RoboticsBrno/RB3203-BlackBox/touchboard/TouchBoard.jpg

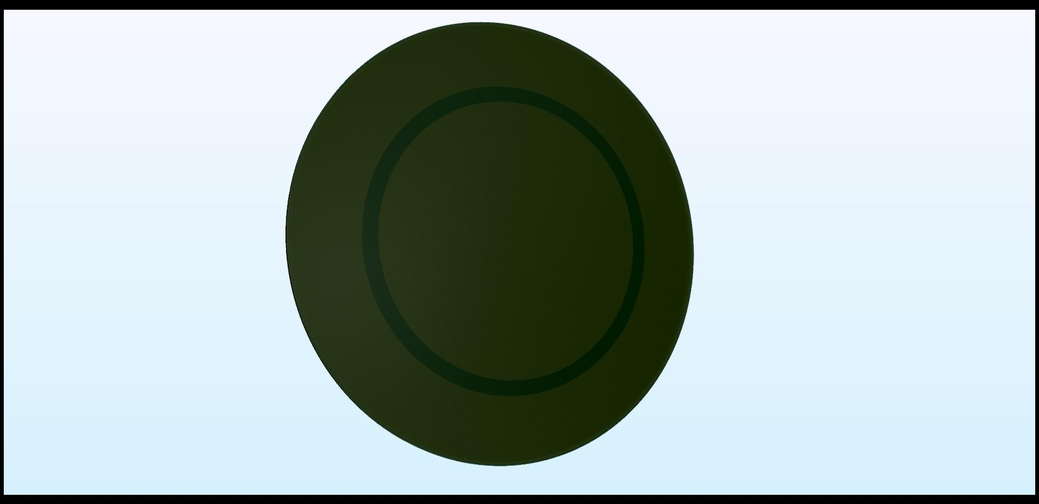
touchboard/TouchBoard.jpg
