RoboticsBrno/RB3203-BlackBox/hw/old/main_board/B.B-V1.0/birokracie/9627741863_awb51.pdf

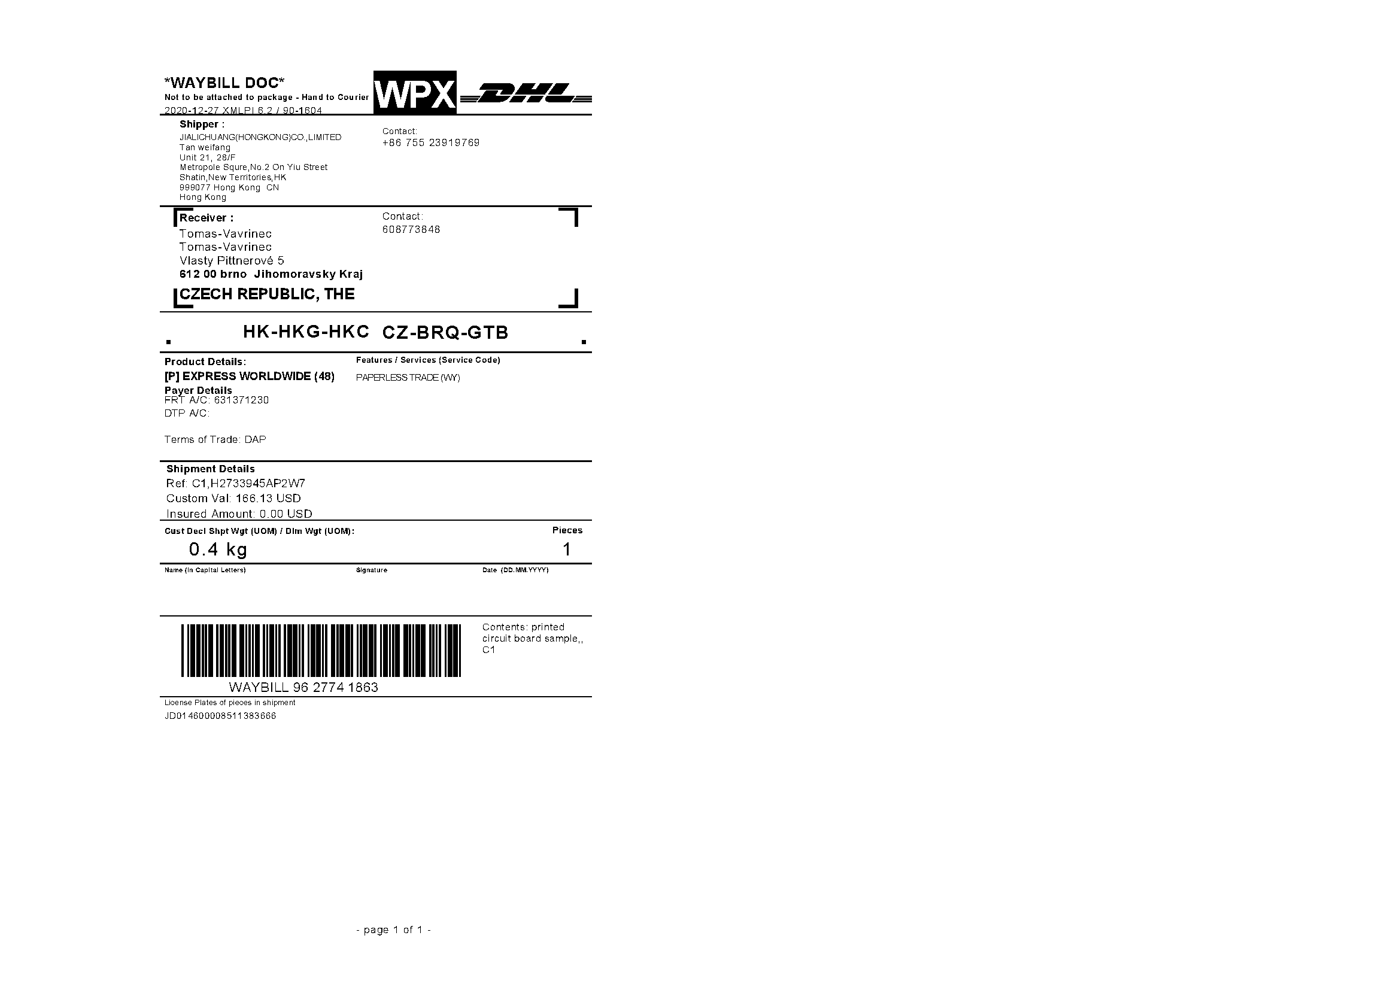
[picture p2: page 1]
