RoboticsBrno/RB3203-BlackBox/hw/old/main_board/B.B-V1.0/birokracie/9627741863_inv50 (1).pdf

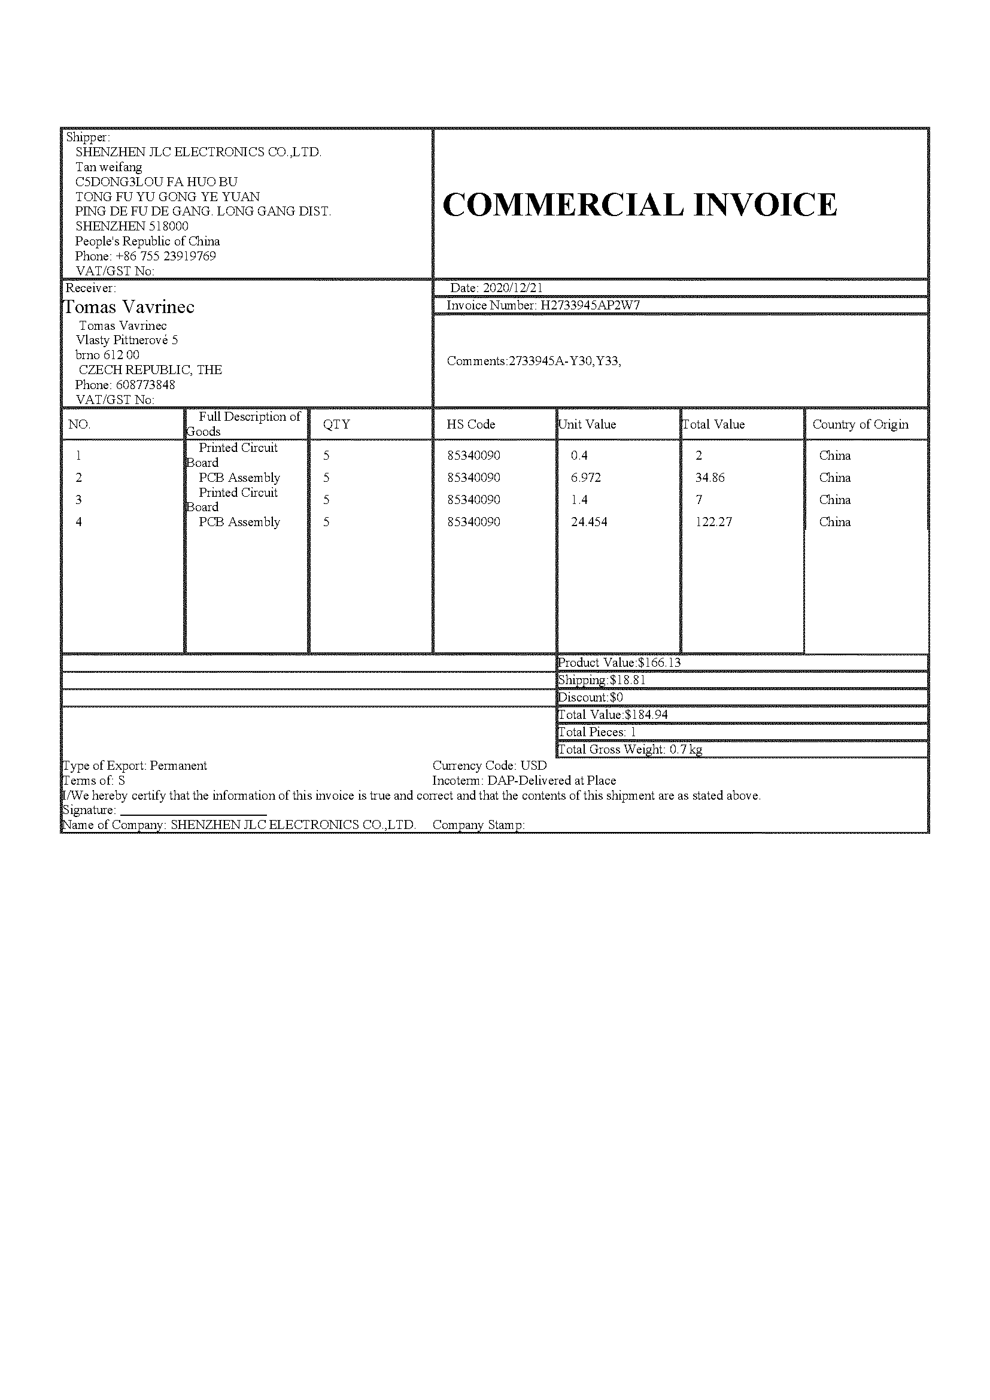
[picture p3: page 1]
