RoboticsBrno/RB3203-BlackBox/touchboard/tmave.png

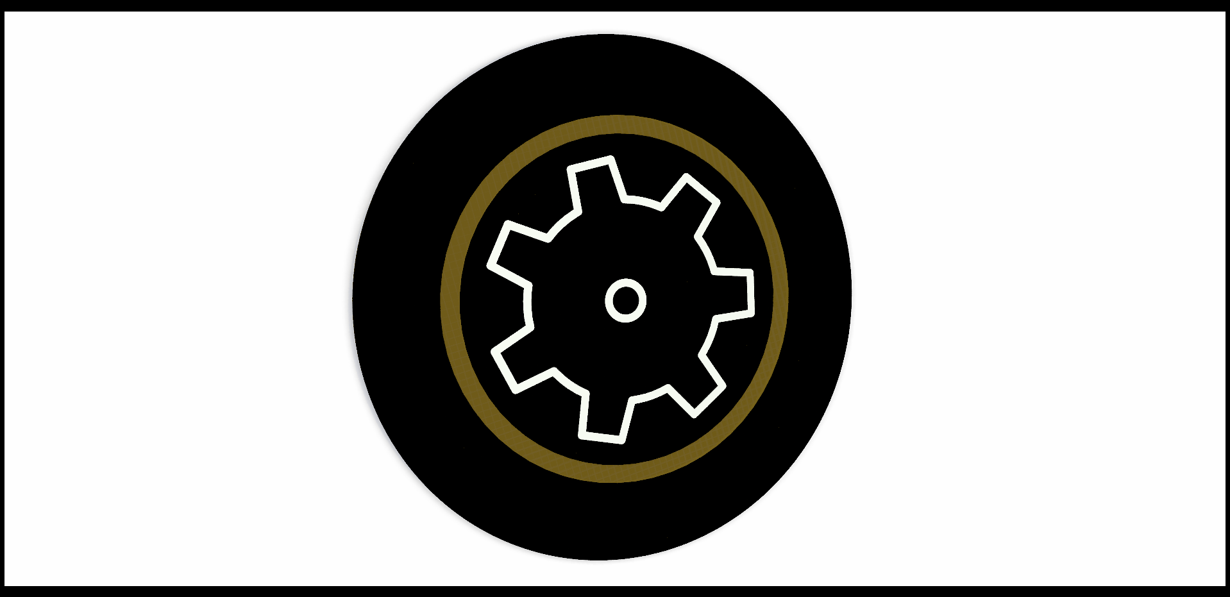
touchboard/tmave.png
