RoboticsBrno/RB3203-BlackBox/touchboard/TouchBoard.png

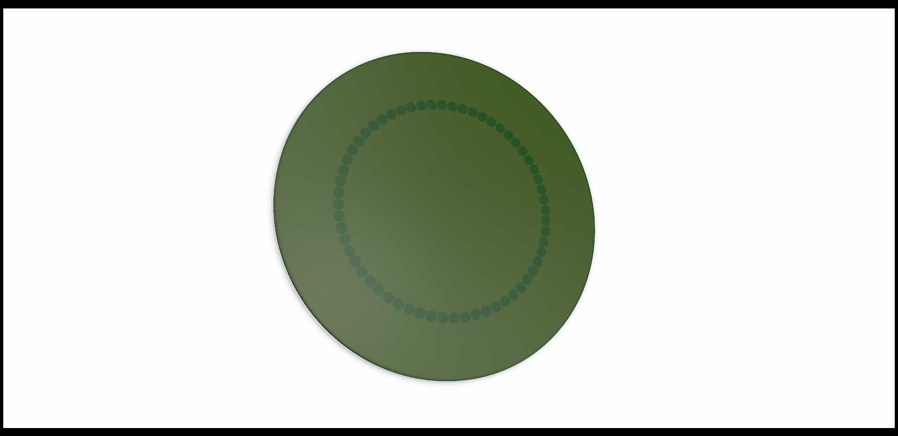
touchboard/TouchBoard.png
