RoboticsBrno/RB3203-BlackBox/main_board/main_board 1.0.0/BOM.xlsx

Comment | Designator | Footprint | LCSC Part #（optional）
2.2nF | C1,C2 | 0402_C | C1531
100nF | C3, C4, C8 | 0402_C | C307331
10uF | C5,C69,C70,C72,C73,C74 | 0402_C | C15195
220nF | C6 | 0402_C | C21120
4.7uF | C7,C71 | 0402_C | C1779
18pF | C9-68 | 0402_C | C1647
 | D1-2 | SMC,DO-214AB | C284071
 | IC1 | SOIC-16_7.5x10.3x1.27P | C9866
 | IC2 | LGA-16_3x3x0.5P | C192585
 | LED4 | LED_0603 | C72041
 | MAX1 | SOIC-8_3.9x4.9x1.27P | C19738
 | Q1,Q4,Q5,Q6,Q10 | SOT-23-3 | C232275
 | Q2,Q3,Q8,Q9 | SOP-8_EP_5.0x5.0x1.27P | C180399
12KΩ | R2-5,R8-9,R16,R20,R24 | 0402_R | C25752
300KΩ | R6 | 0402_R | C25102
220Ω | R7,R10,R21,R23,R25,R26,R47 | 0402_R | C25092
100KΩ | R11,R17,R19,R22 | 0402_R | C25741
120Ω | R12 | 0402_R | C25750
20KΩ | R13-14 | 0402_R | C25765
330KΩ | R15 | 0603_R | C23137
1MΩ | R18 | 0603_R | C22935
 | U1 | QFN-24_EP_4.0x4.0x0.5P | C24112
 | U$2-61 | LED-4_3535 | C114583
