RoboticsBrno/RB3203-BlackBox/(list of files, cad)

Other CAD files:
main_board/B.B-V1.2-Lucerna/3D_vystup/QFN-24-1EP_4x4mm_P0.5mm_EP2.6x2.6mm.step.SLDASM
main_board/B.B-V1.2-Lucerna/3D_vystup/PinHeader_1x04_P2.54mm_Vertical.step.SLDASM
main_board/B.B-V1.2-Lucerna/3D_vystup/LGA-16_3x3mm_P0.5mm.step.SLDASM
main_board/B.B-V1.2-Lucerna/3D_vystup/DFN-6-1EP_3x3mm_P1mm_EP1.5x2.4mm.step.SLDASM
main_board/B.B-V1.2-Lucerna/3D_vystup/JST_EH_B2B-EH-A_1x02_P2.50mm_Vertical.step.SLDASM
main_board/B.B-V1.2-Lucerna/3D_vystup/COMPOUND-22.step.SLDPRT
hw/old/main_board/B.B-V1.2-Lucerna/3D_vystup/PinHeader_1x04_P2.54mm_Vertical.step.SLDASM
hw/old/main_board/B.B/3D_vystup/LGA-16_3x3mm_P0.5mm.step.SLDASM
hw/old/main_board/B.B-V1.1/3D_vystup/PinHeader_1x04_P2.54mm_Vertical.step.SLDASM
hw/old/main_board/B.B/3D_vystup/QFN-24-1EP_4x4mm_P0.5mm_EP2.6x2.6mm.step.SLDASM
hw/old/main_board/B.B-V1.2-Lucerna/3D_vystup/LGA-16_3x3mm_P0.5mm.step.SLDASM
hw/old/main_board/B.B/3D_vystup/DFN-6-1EP_3x3mm_P1mm_EP1.5x2.4mm.step.SLDASM
hw/old/main_board/B.B-V1.2-Lucerna/3D_vystup/QFN-24-1EP_4x4mm_P0.5mm_EP2.6x2.6mm.step.SLDASM
hw/old/main_board/B.B/3D_vystup/PinHeader_1x04_P2.54mm_Vertical.step.SLDASM
hw/old/main_board/B.B-V1.2-Lucerna/3D_vystup/JST_EH_B2B-EH-A_1x02_P2.50mm_Vertical.step.SLDASM
hw/old/main_board/B.B/3D_vystup/JST_EH_B2B-EH-A_1x02_P2.50mm_Vertical.step.SLDASM
hw/old/main_board/B.B-V1.2-Lucerna/3D_vystup/DFN-6-1EP_3x3mm_P1mm_EP1.5x2.4mm.step.SLDASM
hw/old/main_board/B.B-V1.1/3D_vystup/DFN-6-1EP_3x3mm_P1mm_EP1.5x2.4mm.step.SLDASM
hw/old/main_board/B.B-V1.1/3D_vystup/COMPOUND-22.step.SLDPRT
hw/old/main_board/B.B-V1.1/3D_vystup/JST_EH_B2B-EH-A_1x02_P2.50mm_Vertical.step.SLDASM
hw/old/main_board/B.B-V1.1/3D_vystup/LGA-16_3x3mm_P0.5mm.step.SLDASM
hw/old/main_board/B.B-V1.1/3D_vystup/QFN-24-1EP_4x4mm_P0.5mm_EP2.6x2.6mm.step.SLDASM
hw/old/main_board/B.B-V1.1/3D_vystup/SOLID-10.step.SLDPRT
hw/old/main_board/B.B-V1.1/3D_vystup/SOLID-12.step.SLDPRT
hw/old/main_board/B.B-V1.1/3D_vystup/SOLID-13.step.SLDPRT
hw/old/main_board/B.B-V1.1/3D_vystup/SOLID-15.step.SLDPRT
hw/old/main_board/B.B-V1.1/3D_vystup/SOLID-16.step.SLDPRT
hw/old/main_board/B.B-V1.1/3D_vystup/SOLID-17.step.SLDPRT
hw/old/main_board/B.B-V1.1/3D_vystup/SOLID-18.step.SLDPRT
hw/old/main_board/B.B-V1.1/3D_vystup/SOLID-2.step.SLDPRT
hw/old/main_board/B.B-V1.1/3D_vystup/SOLID-5.step.SLDPRT
hw/old/main_board/B.B-V1.1/3D_vystup/SOLID-8.step.SLDPRT
hw/old/main_board/B.B-V1.1/3D_vystup/SOLID-9.step.SLDPRT
hw/old/main_board/B.B-V1.2-Lucerna/3D_vystup/COMPOUND-22.step.SLDPRT
hw/old/main_board/B.B/3D_vystup/COMPOUND-22.step.SLDPRT
