RoboticsBrno/RB3203-BlackBox/main_board/B.B-V1.2-Lucerna/B.B.kicad_pcb

## KiCad design main_board/B.B-V1.2-Lucerna/B.B.kicad_pcb (2021-05-26)

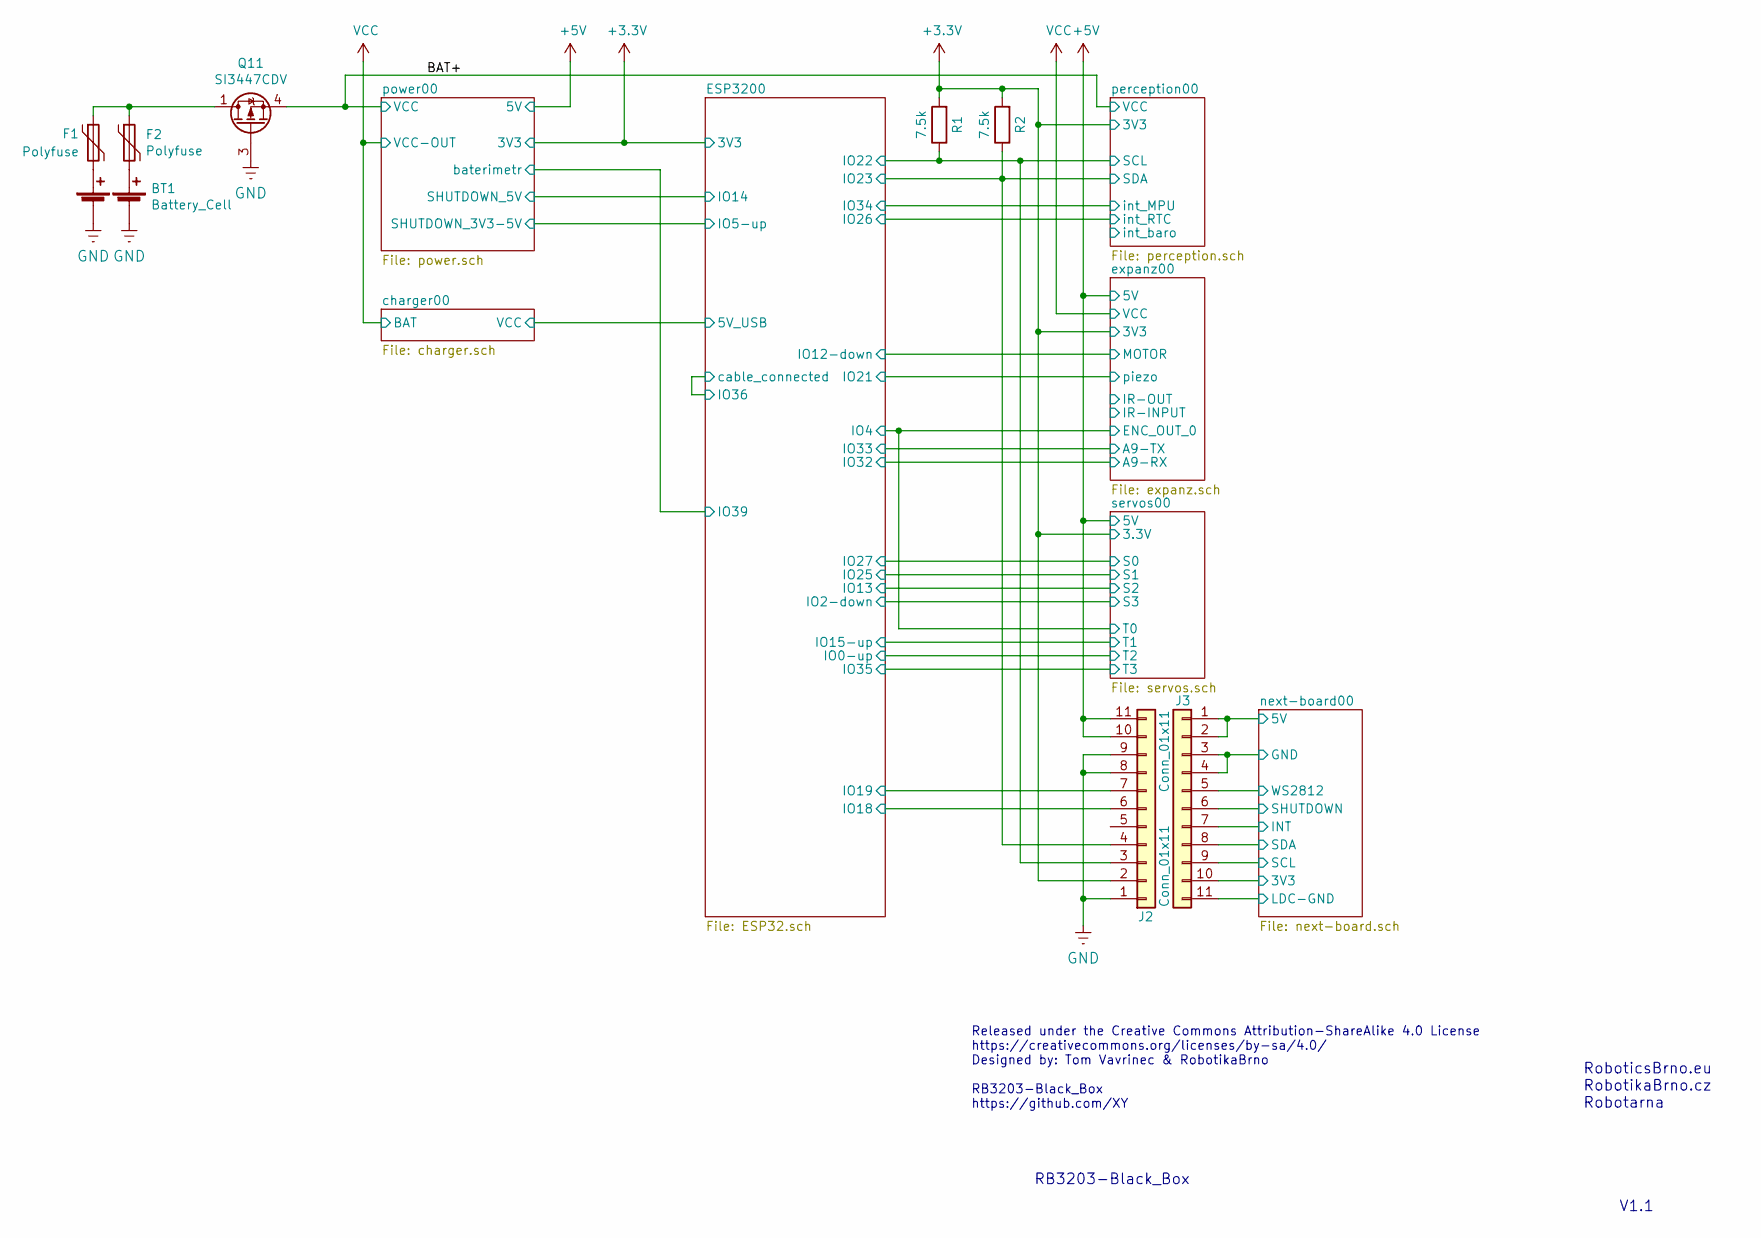
[picture p6: schematic B.B.sch]

Parts:
BT1: Battery_Cell; 18650-holder
F1, F2: Polyfuse; L_1206_3216Metric; LCSC C20988
J2, J3: Conn_01x11; PinHeader_1x11_P2.54mm_Vertical
Q11: SI3447CDV; TSOP-6_1.5x3.0x0.95P; LCSC C144884
R1, R2: 7.5k; R_0402_1005Metric; LCSC C25918

Connections:
+3V3: J2.2, R1.2, R2.2; also elsewhere on the board
+5V: J2.10, J2.11; also elsewhere on the board
/BAT+: Q11.4 (S); also elsewhere on the board
/ESP3200/IO18: J2.6; also elsewhere on the board
/ESP3200/IO19: J2.7; also elsewhere on the board
/ESP3200/IO22: J2.3, R1.1; also elsewhere on the board
/ESP3200/IO23: J2.4, R2.1; also elsewhere on the board
/next-board00/3V3: J3.10; also elsewhere on the board
/next-board00/5V: J3.1, J3.2; also elsewhere on the board
/next-board00/GND: J3.3, J3.4; also elsewhere on the board
/next-board00/INT: J3.7; also elsewhere on the board
/next-board00/LDC-GND: J3.11; also elsewhere on the board
/next-board00/SCL: J3.9; also elsewhere on the board
/next-board00/SDA: J3.8; also elsewhere on the board
/next-board00/SHUTDOWN: J3.6; also elsewhere on the board
/next-board00/WS2812: J3.5; also elsewhere on the board
unnamed: BT1.1 (+), F2.2
unnamed: BT1.3 (+), F1.2
unnamed: F1.1, F2.1, Q11.1 (D), Q11.2, Q11.5, Q11.6

Notes on the sheet:
Released under the Creative Commons Attribution-ShareAlike 4.0 License https://creativecommons.org/licenses/by-sa/4.0/ Designed by: Tom Vavrinec & RobotikaBrno RB3203-Black_Box https://github.com/XY
RoboticsBrno.eu RobotikaBrno.cz Robotarna
V1.1
RB3203-Black_Box

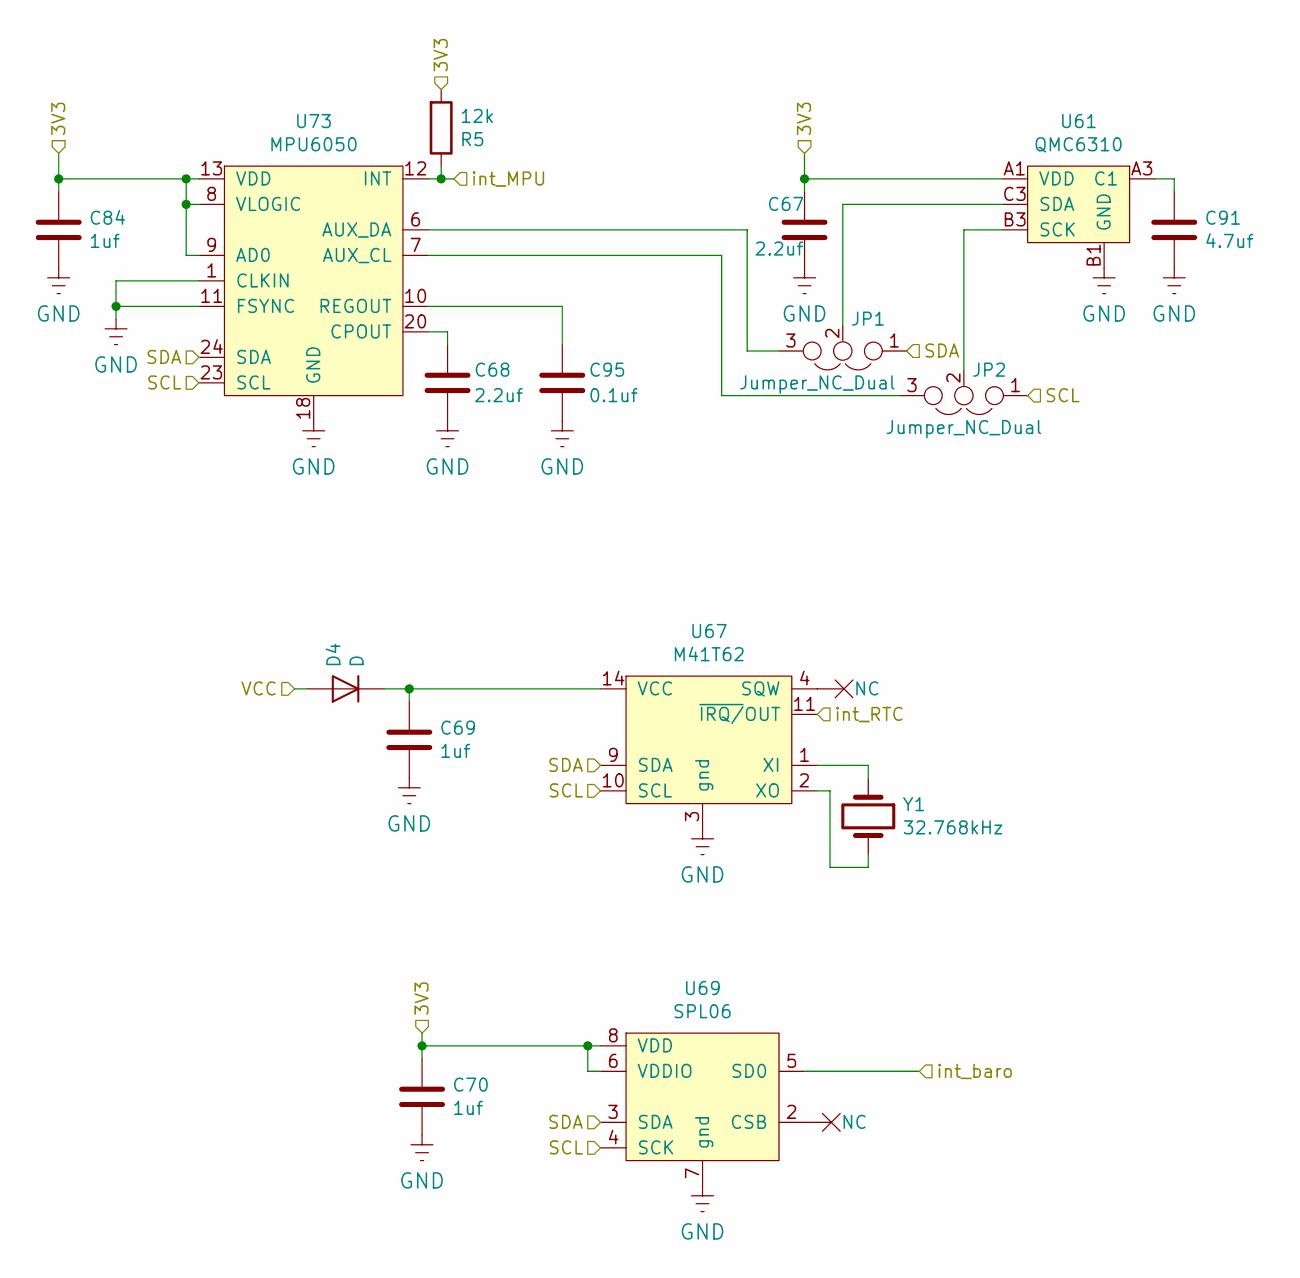
[picture p7: schematic perception.sch]

Parts:
C67, C68: 2.2uf; C_0402_1005Metric; LCSC C12530
C84, C117, C118: 1uf; R_0402_1005Metric; LCSC C52923
C91: 4.7uf; C_0402_1005Metric; LCSC C23733
C95: 0.1uf; R_0402_1005Metric; LCSC C1525
D4: D; SOD-323; LCSC C109204
JP1, JP2: Jumper_NC_Dual; SolderJumper-3_P1.3mm_Bridged12_RoundedPad1.0x1.5mm_NumberL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
R5: 12k; R_0402_1005Metric; LCSC C25752
U61: QMC6310; LCSC C669299
U70: M41T62; QFN-16-1EP_3x3mm_P0.5mm_EP1.7x1.7mm; LCSC C113207
U71: SPL06; SMD-8_2x2.5x0.65P; LCSC C2684428
U73: MPU6050; QFN-24-1EP_4x4mm_P0.5mm_EP2.6x2.6mm; LCSC C24112
Y1: 32.768kHz; SMD-3215_2P; LCSC C156244

Connections:
+3V3: C67.1, C84.1, R5.2, U61.A1 (VDD), U71.6 (VDDIO), U71.8 (VDD), U73.8 (VLOGIC), U73.9 (AD0), U73.13 (VDD); also elsewhere on the board
/BAT+: D4.2 (A); also elsewhere on the board
/ESP3200/IO22: JP2.1, U71.4 (SCK), U73.23 (SCL); also elsewhere on the board
/ESP3200/IO23: JP1.1, U71.3 (SDA), U73.24 (SDA); also elsewhere on the board
/ESP3200/IO34: R5.1, U73.12 (INT); also elsewhere on the board
unnamed: C68.1, U73.20 (CPOUT)
unnamed 57: D4.1 (K); also elsewhere on the board
unnamed: C91.1, U61.A3 (C1)
unnamed: C95.1, U73.10 (REGOUT)
unnamed: JP1.2, U61.C3 (SDA)
unnamed: JP1.3, U73.6 (AUX_DA)
unnamed: JP2.2, U61.B3 (SCK)
unnamed: JP2.3, U73.7 (AUX_CL)
unnamed 150: Y1.1; also elsewhere on the board
unnamed 151: Y1.2; also elsewhere on the board

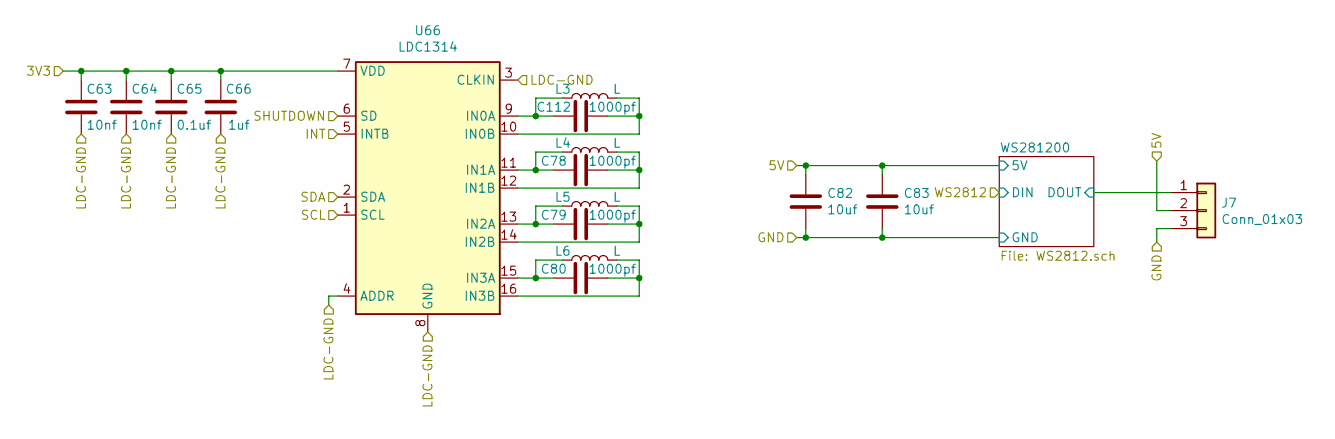
[picture p8: schematic next-board.sch]

Parts:
C63, C64: 10nf; C_0402_1005Metric; LCSC C15195
C65: 0.1uf; R_0402_1005Metric; LCSC C1525
C66: 1uf; C_0402_1005Metric; LCSC C52923
C78, C79, C80, C112: 1000pf; C_0402_1005Metric; LCSC C1523
C82, C83: 10uf; C_0805_2012Metric; LCSC C15850
J7: Conn_01x03; PinHeader_1x03_P2.54mm_Vertical
L3, L4, L5, L6: L; coil
U66: LDC1314; WQFN-16-1EP_4x4mm_P0.5mm_EP2.6x2.6mm_ThermalVias; LCSC C80399

Connections:
/next-board00/3V3: C63.1, C64.1, C65.1, C66.2, U66.7 (VDD); also elsewhere on the board
/next-board00/5V: C82.1, C83.1, J7.2; also elsewhere on the board
/next-board00/GND: C82.2, C83.2, J7.3; also elsewhere on the board
/next-board00/INT: U66.5 (INTB); also elsewhere on the board
/next-board00/LDC-GND: C63.2, C64.2, C65.2, C66.1, U66.3 (CLKIN), U66.4 (ADDR), U66.8 (GND), U66.17 (GND); also elsewhere on the board
/next-board00/SCL: U66.1 (SCL); also elsewhere on the board
/next-board00/SDA: U66.2 (SDA); also elsewhere on the board
/next-board00/SHUTDOWN: U66.6 (SD); also elsewhere on the board
/next-board00/WS281200/DOUT: J7.1; also elsewhere on the board
unnamed: C78.1, L4.1, U66.12 (IN1B)
unnamed: C78.2, L4.2, U66.11 (IN1A)
unnamed: C79.1, L5.1, U66.14 (IN2B)
unnamed: C79.2, L5.2, U66.13 (IN2A)
unnamed: C80.1, L6.1, U66.16 (IN3B)
unnamed: C80.2, L6.2, U66.15 (IN3A)
unnamed: C112.1, L3.1, U66.10 (IN0B)
unnamed: C112.2, L3.2, U66.9 (IN0A)

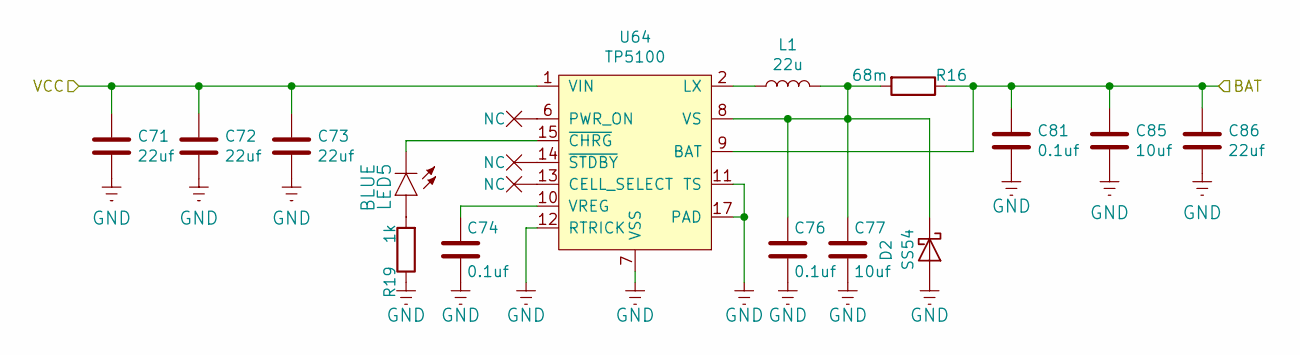
[picture p9: schematic charger.sch]

Parts:
C71, C72, C73, C86: 22uf; C_0805_2012Metric; LCSC C45783
C74, C76, C81: 0.1uf; C_0805_2012Metric; LCSC C49678
C77, C85: 10uf; C_0805_2012Metric; LCSC C15850
D2: SS54; DO-214AC; LCSC C22452
L1: 22u; MCF-1040; LCSC C169268
LED5: BLUE; LED_0603_1608Metric; LCSC C72041
R16: 68m; R_1210_3225Metric; LCSC C422195
R19: 1k; R_0402_1005Metric; LCSC C11702
U64: TP5100; QFN-16-1EP_4x4mm_P0.65mm_EP2.5x2.5mm_ThermalVias; LCSC C379389

Connections:
unnamed: C74.1, U64.10 (VREG)
unnamed: C76.1, C77.1, D2.1 (K), L1.2, R16.2, U64.8 (VS)
unnamed: L1.1, U64.2 (LX), U64.3 (LX)
unnamed: LED5.1 (C), U64.15 (~CHRG)
unnamed: LED5.2 (A), R19.2
VIN: C71.1, C72.1, C73.1, U64.1 (VIN), U64.4 (VIN), U64.5 (VIN), U64.16 (VIN); also elsewhere on the board

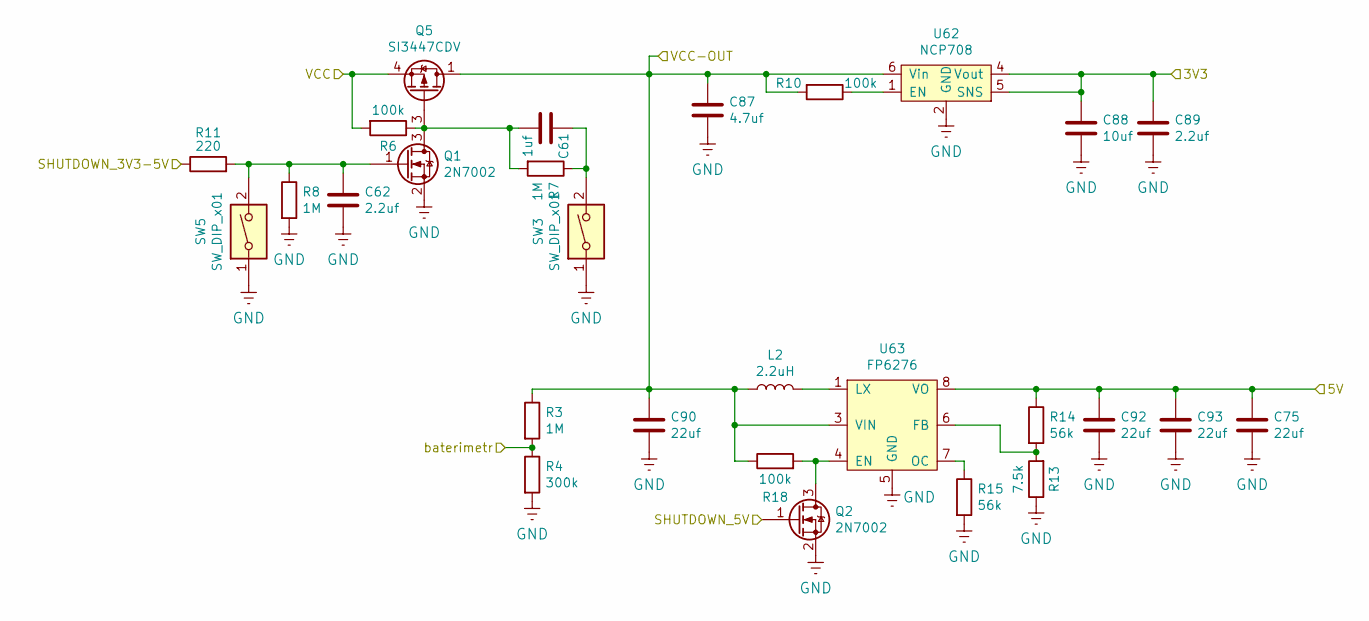
[picture p10: schematic power.sch]

Parts:
C61: 1uf; C_0402_1005Metric; LCSC C52923
C62, C89: 2.2uf; C_0805_2012Metric; LCSC C49217
C75, C90, C92, C93: 22uf; C_0805_2012Metric; LCSC C45783
C87: 4.7uf; C_0805_2012Metric; LCSC C1779
C88: 10uf; C_0805_2012Metric; LCSC C15850
L2: 2.2uH; MWSA0603_6.6x7.1x3.0; LCSC C351096
Q1, Q2: 2N7002; SOT-23; LCSC C8545
Q5: SI3447CDV; TSOP-6_1.5x3.0x0.95P; LCSC C144884
R3, R7, R8: 1M; R_0402_1005Metric; LCSC C26083
R4: 300k; C_0402_1005Metric; LCSC C25774
R6, R10, R18: 100k; R_0402_1005Metric; LCSC C25741
R11: 220; R_0402_1005Metric; LCSC C25092
R13: 7.5k; R_0402_1005Metric; LCSC C25918
R14, R15: 56k; R_0402_1005Metric; LCSC C25796
SW3, SW5: SW_DIP_x01; SW_Push_1P1T_NO_CK_KSC6xxJ; LCSC C318889
U62: NCP708; UDFN6_3x3; LCSC C183178
U63: FP6276; SOIC-8-1EP_3.9x4.9mm_P1.27mm_EP2.41x3.81mm_ThermalVias; LCSC C82652

Connections:
+3V3: C88.1, C89.1, U62.4 (Vout), U62.5 (SNS); also elsewhere on the board
+5V: C75.1, C92.1, C93.1, R14.1, U63.8 (VO); also elsewhere on the board
/BAT+: Q5.4 (S), R6.2; also elsewhere on the board
/ESP3200/IO5-up: R11.1; also elsewhere on the board
/ESP3200/IO14: Q2.1 (G); also elsewhere on the board
/ESP3200/IO39: R3.2, R4.1; also elsewhere on the board
LX: L2.2, U63.1 (LX), U63.2 (LX)
unnamed: C61.1, Q1.3 (D), Q5.3 (G), R6.1, R7.2
unnamed: C61.2, R7.1, SW3.2
unnamed: C62.1, Q1.1 (G), R8.1, R11.2, SW5.2
unnamed: Q2.3 (D), R18.2, U63.4 (EN)
unnamed: R10.1, U62.1 (EN)
unnamed: R13.2, R14.2, U63.6 (FB)
unnamed: R15.1, U63.7 (OC)

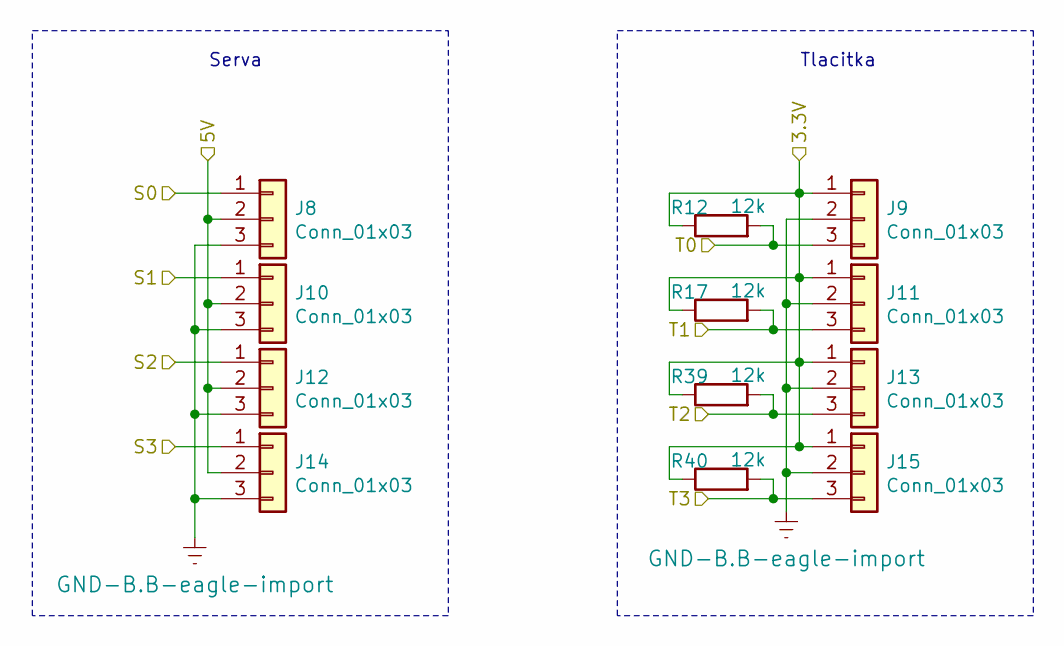
[picture p11: schematic servos.sch]

Parts:
J8, J9, J10, J11, J12, J13, J14, J15: Conn_01x03; PinHeader_1x03_P2.54mm_Vertical; LCSC C306138
R12, R17, R39, R40: 12k; R_0402_1005Metric; LCSC C25752

Connections:
+3V3: J9.1, J11.1, J13.1, J15.1, R12.1, R17.1, R39.1, R40.1; also elsewhere on the board
+5V: J8.2, J10.2, J12.2, J14.2; also elsewhere on the board
/ESP3200/IO0-up: J13.3, R39.2; also elsewhere on the board
/ESP3200/IO2-down: J14.1; also elsewhere on the board
/ESP3200/IO4: J9.3, R12.2; also elsewhere on the board
/ESP3200/IO13: J12.1; also elsewhere on the board
/ESP3200/IO15-up: J11.3, R17.2; also elsewhere on the board
/ESP3200/IO25: J10.1; also elsewhere on the board
/ESP3200/IO27: J8.1; also elsewhere on the board
/ESP3200/IO35: J15.3, R40.2; also elsewhere on the board

Notes on the sheet:
Tlacitka
Serva

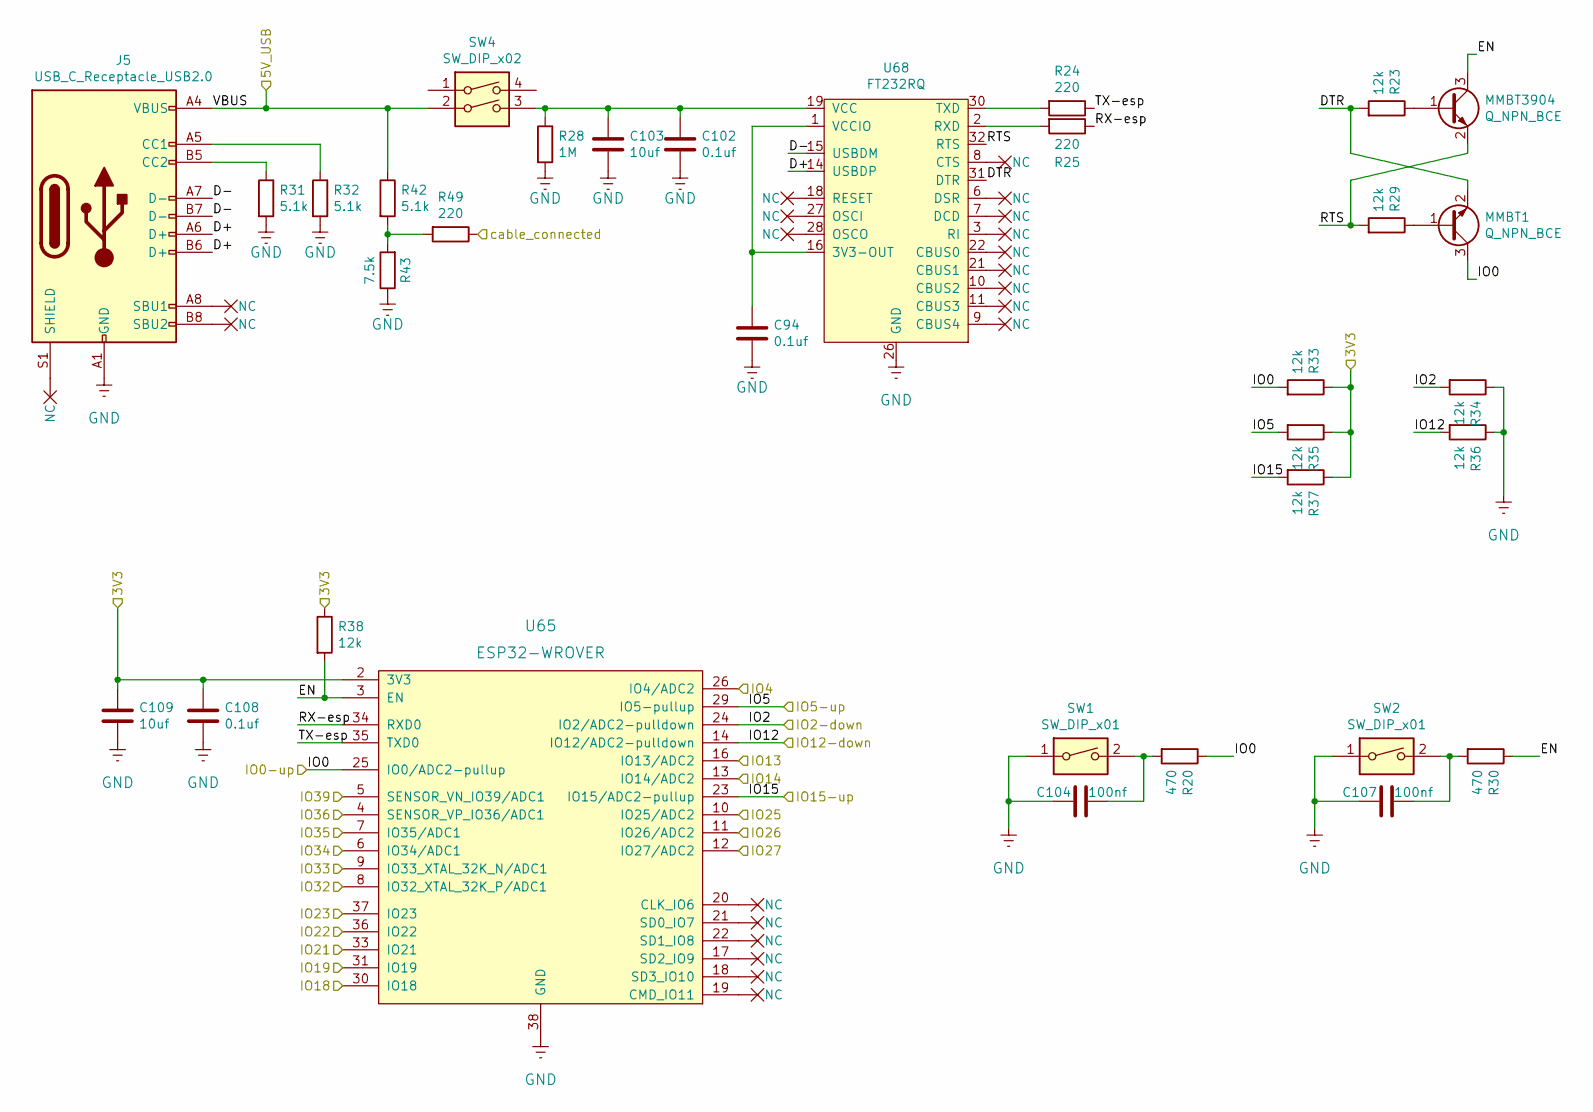
[picture p12: schematic ESP32.sch]

Parts:
C94, C102, C108: 0.1uf; C_0805_2012Metric; LCSC C49678
C103, C109: 10uf; C_0805_2012Metric; LCSC C15850
C104, C107: 100nf; C_0402_1005Metric; LCSC C1525
J5: USB_C_Receptacle_USB2.0; USB_C_Female-16Pin-HPJF; LCSC C165948
MMBT1, MMBT3904: Q_NPN_BCE; SOT-23; LCSC C20526
R20, R30: 470; R_0402_1005Metric; LCSC C25117
R23, R29, R33, R34, R35, R36, R37, R38: 12k; R_0402_1005Metric; LCSC C25752
R24, R25, R49: 220; R_0402_1005Metric; LCSC C25092
R28: 1M; R_0402_1005Metric; LCSC C26083
R31, R32, R42: 5.1k; R_0402_1005Metric; LCSC C25905
R43: 7.5k; R_0402_1005Metric; LCSC C25918
SW1, SW2: SW_DIP_x01; SW_Push_1P1T_NO_CK_KSC6xxJ; LCSC C318889
SW4: SW_DIP_x02; SW-SMD-4; LCSC C319052
U65: ESP32-WROVER; LCSC C503591
U68: FT232RQ; QFN-32-1EP_5x5mm_P0.5mm_EP3.3x3.3mm; LCSC C14090

Connections:
+3V3: C108.1, C109.1, R33.1, R35.1, R37.1, R38.1, U65.2 (3V3); also elsewhere on the board
/ESP3200/D+: J5.A6 (D+), J5.B6 (D+), U68.14 (USBDP)
/ESP3200/D-: J5.A7 (D-), J5.B7 (D-), U68.15 (USBDM)
/ESP3200/DTR: MMBT1.2 (E), R23.2, U68.31 (DTR)
/ESP3200/EN: MMBT3904.3 (C), R30.1, R38.2, U65.3 (EN)
/ESP3200/IO0-up: MMBT1.3 (C), R20.1, R33.2, U65.25 (IO0/ADC2-pullup); also elsewhere on the board
/ESP3200/IO2-down: R34.2, U65.24 (IO2/ADC2-pulldown); also elsewhere on the board
/ESP3200/IO4: U65.26 (IO4/ADC2); also elsewhere on the board
/ESP3200/IO5-up: R35.2, U65.29 (IO5-pullup); also elsewhere on the board
/ESP3200/IO12-down: R36.2, U65.14 (IO12/ADC2-pulldown); also elsewhere on the board
/ESP3200/IO13: U65.16 (IO13/ADC2); also elsewhere on the board
/ESP3200/IO14: U65.13 (IO14/ADC2); also elsewhere on the board
/ESP3200/IO15-up: R37.2, U65.23 (IO15/ADC2-pullup); also elsewhere on the board
/ESP3200/IO18: U65.30 (IO18); also elsewhere on the board
/ESP3200/IO19: U65.31 (IO19); also elsewhere on the board
/ESP3200/IO21: U65.33 (IO21); also elsewhere on the board
/ESP3200/IO22: U65.36 (IO22); also elsewhere on the board
/ESP3200/IO23: U65.37 (IO23); also elsewhere on the board
/ESP3200/IO25: U65.10 (IO25/ADC2); also elsewhere on the board
/ESP3200/IO26: U65.11 (IO26/ADC2); also elsewhere on the board
/ESP3200/IO27: U65.12 (IO27/ADC2); also elsewhere on the board
/ESP3200/IO34: U65.6 (IO34/ADC1); also elsewhere on the board
/ESP3200/IO35: U65.7 (IO35/ADC1); also elsewhere on the board
/ESP3200/IO36: R49.1, U65.4 (SENSOR_VP_IO36/ADC1)
/ESP3200/IO39: U65.5 (SENSOR_VN_IO39/ADC1); also elsewhere on the board
/ESP3200/RTS: MMBT3904.2 (E), R29.2, U68.32 (RTS)
/ESP3200/RX-esp: R25.1, U65.34 (RXD0)
/ESP3200/TX-esp: R24.1, U65.35 (TXD0)
/expanz00/A9-RX: U65.8 (IO32_XTAL_32K_P/ADC1); also elsewhere on the board
/expanz00/A9-TX: U65.9 (IO33_XTAL_32K_N/ADC1); also elsewhere on the board
unnamed: C94.1, U68.1 (VCCIO), U68.16 (3V3-OUT)
unnamed: C102.1, C103.1, R28.1, SW4.3, U68.19 (VCC)
unnamed: C104.2, R20.2, SW1.2
unnamed: C107.2, R30.2, SW2.2
unnamed: J5.A5 (CC1), R32.1
unnamed: J5.B5 (CC2), R31.1
unnamed: MMBT1.1 (B), R29.1
unnamed: MMBT3904.1 (B), R23.1
unnamed: R24.2, U68.30 (TXD)
unnamed: R25.2, U68.2 (RXD)
unnamed: R42.2, R43.2, R49.2
VIN: J5.A4 (VBUS), J5.A9 (VBUS), J5.B4 (VBUS), J5.B9 (VBUS), R42.1, SW4.2; also elsewhere on the board

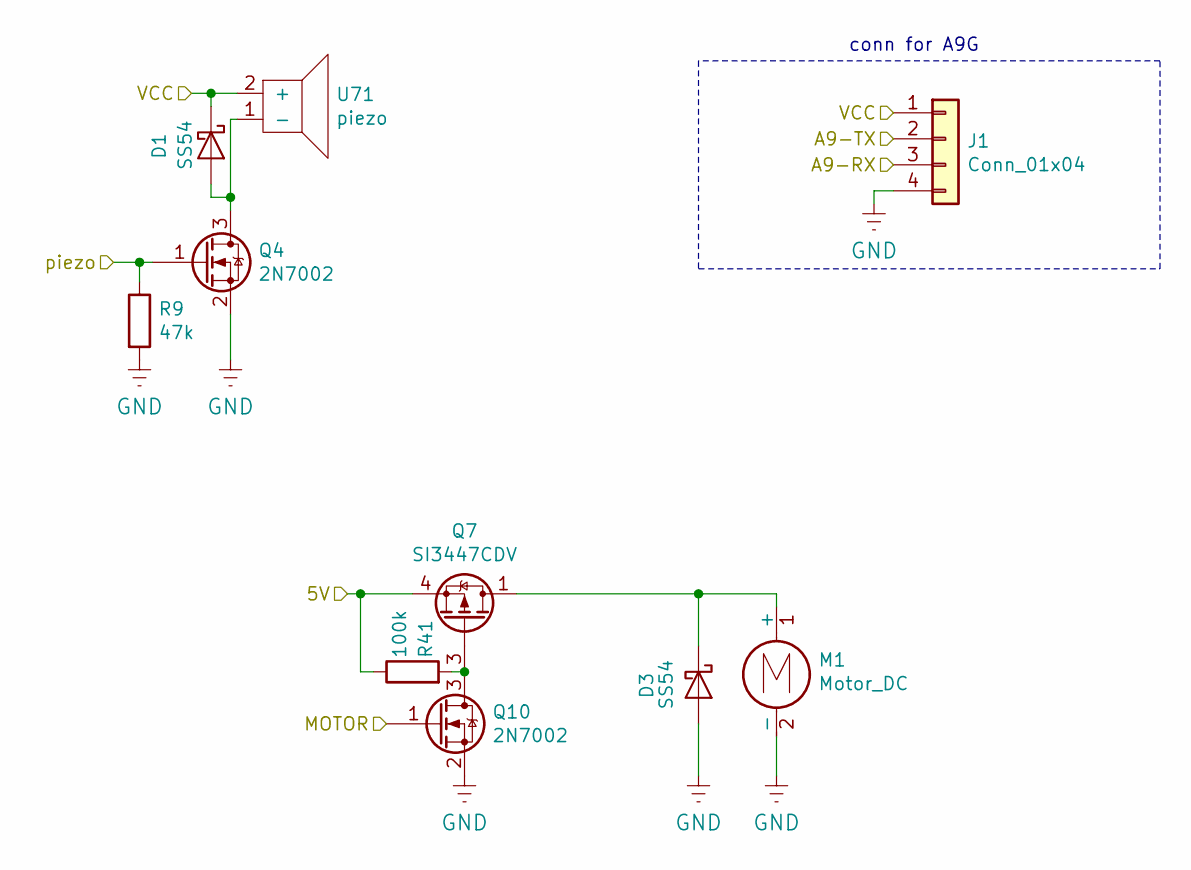
[picture p13: schematic expanz.sch]

Parts:
D1, D3: SS54; DO-214AC; LCSC C22452
J1: Conn_01x04; PinHeader_1x04_P2.54mm_Vertical
M1: Motor_DC; JST_EH_B2B-EH-A_1x02_P2.50mm_Vertical
Q4, Q10: 2N7002; SOT-23; LCSC C8545
Q7: SI3447CDV; TSOP-6_1.5x3.0x0.95P; LCSC C144884
R9: 47k; R_0402_1005Metric; LCSC C25792
R41: 100k; R_0402_1005Metric; LCSC C25741
U71: piezo; LCSC C511707

Connections:
+5V: Q7.4 (S), R41.1; also elsewhere on the board
/ESP3200/IO12-down: Q10.1 (G); also elsewhere on the board
/ESP3200/IO21: Q4.1 (G), R9.1; also elsewhere on the board
/expanz00/A9-RX: J1.3; also elsewhere on the board
/expanz00/A9-TX: J1.2; also elsewhere on the board
unnamed: D3.1 (K), M1.1 (+), Q7.1 (D), Q7.2, Q7.5, Q7.6
unnamed: Q7.3 (G), Q10.3 (D), R41.2

Notes on the sheet:
conn for A9G

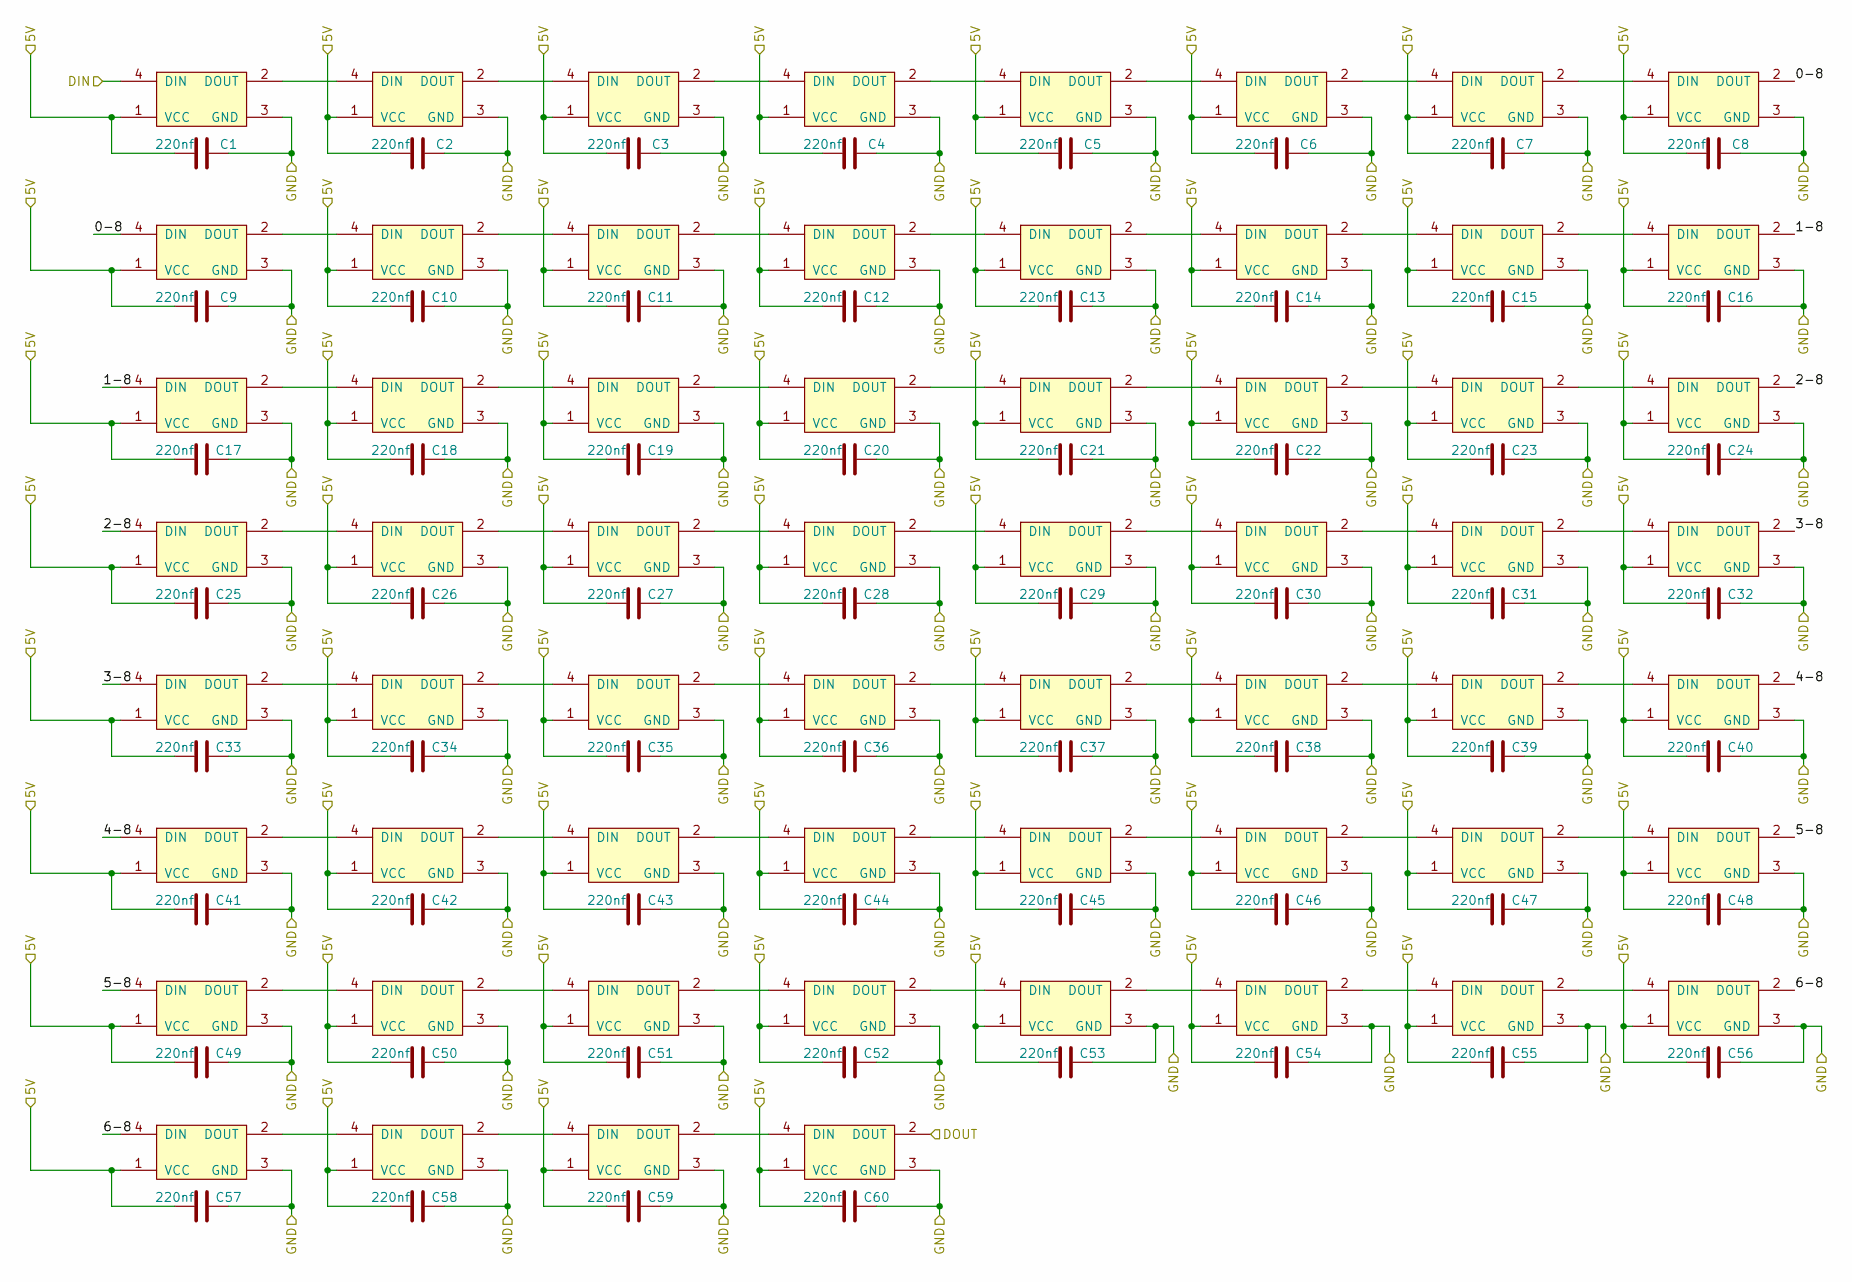
[picture p14: schematic WS2812.sch]

Parts:
C1, C2, C3, C4, C5, C6, C7, C8, C9, C10, C11, C12, C13, C14, C15, C16, C17, C18, C19, C20, C21, C22, C23, C24, C25, C26, C27, C28, C29, C30, C31, C32, C33, C34, C35, C36, C37, C38, C39, C40, C41, C42, C43, C44, C45, C46, C47, C48, C49, C50, C51, C52, C53, C54, C55, C56, C57, C58, C59, C60: 220nf; C_0402_1005Metric; LCSC C16772
U1, U2, U3, U4, U5, U6, U7, U8, U9, U10, U11, U12, U13, U14, U15, U16, U17, U18, U19, U20, U21, U22, U23, U24, U25, U26, U27, U28, U29, U30, U31, U32, U33, U34, U35, U36, U37, U38, U39, U40, U41, U42, U43, U44, U45, U46, U47, U48, U49, U50, U51, U52, U53, U54, U55, U56, U57, U58, U59, U60: WS2812; LCSC C114583

Connections:
/next-board00/5V: C1.2, C2.2, C3.2, C4.2, C5.2, C6.2, C7.2, C8.2, C9.2, C10.2, C11.2, C12.2, C13.2, C14.2, C15.2, C16.2, C17.2, C18.2, C19.2, C20.2, C21.2, C22.2, C23.2, C24.2, C25.2, C26.2, C27.2, C28.2, C29.2, C30.2, C31.2, C32.2, C33.2, C34.2, C35.2, C36.2, C37.2, C38.2, C39.2, C40.2, C41.2, C42.2, C43.2, C44.2, C45.2, C46.2, C47.2, C48.2, C49.2, C50.2, C51.2, C52.2, C53.2, C54.2, C55.2, C56.2, C57.2, C58.2, C59.2, C60.2, U1.1 (VCC), U2.1 (VCC), U3.1 (VCC), U4.1 (VCC), U5.1 (VCC), U6.1 (VCC), U7.1 (VCC), U8.1 (VCC), U9.1 (VCC), U10.1 (VCC), U11.1 (VCC), U12.1 (VCC), U13.1 (VCC), U14.1 (VCC), U15.1 (VCC), U16.1 (VCC), U17.1 (VCC), U18.1 (VCC), U19.1 (VCC), U20.1 (VCC), U21.1 (VCC), U22.1 (VCC), U23.1 (VCC), U24.1 (VCC), U25.1 (VCC), U26.1 (VCC), U27.1 (VCC), U28.1 (VCC), U29.1 (VCC), U30.1 (VCC), U31.1 (VCC), U32.1 (VCC), U33.1 (VCC), U34.1 (VCC), U35.1 (VCC), U36.1 (VCC), U37.1 (VCC), U38.1 (VCC), U39.1 (VCC), U40.1 (VCC), U41.1 (VCC), U42.1 (VCC), U43.1 (VCC), U44.1 (VCC), U45.1 (VCC), U46.1 (VCC), U47.1 (VCC), U48.1 (VCC), U49.1 (VCC), U50.1 (VCC), U51.1 (VCC), U52.1 (VCC), U53.1 (VCC), U54.1 (VCC), U55.1 (VCC), U56.1 (VCC), U57.1 (VCC), U58.1 (VCC), U59.1 (VCC), U60.1 (VCC); also elsewhere on the board
/next-board00/GND: C1.1, C2.1, C3.1, C4.1, C5.1, C6.1, C7.1, C8.1, C9.1, C10.1, C11.1, C12.1, C13.1, C14.1, C15.1, C16.1, C17.1, C18.1, C19.1, C20.1, C21.1, C22.1, C23.1, C24.1, C25.1, C26.1, C27.1, C28.1, C29.1, C30.1, C31.1, C32.1, C33.1, C34.1, C35.1, C36.1, C37.1, C38.1, C39.1, C40.1, C41.1, C42.1, C43.1, C44.1, C45.1, C46.1, C47.1, C48.1, C49.1, C50.1, C51.1, C52.1, C53.1, C54.1, C55.1, C56.1, C57.1, C58.1, C59.1, C60.1, U1.3 (GND), U2.3 (GND), U3.3 (GND), U4.3 (GND), U5.3 (GND), U6.3 (GND), U7.3 (GND), U8.3 (GND), U9.3 (GND), U10.3 (GND), U11.3 (GND), U12.3 (GND), U13.3 (GND), U14.3 (GND), U15.3 (GND), U16.3 (GND), U17.3 (GND), U18.3 (GND), U19.3 (GND), U20.3 (GND), U21.3 (GND), U22.3 (GND), U23.3 (GND), U24.3 (GND), U25.3 (GND), U26.3 (GND), U27.3 (GND), U28.3 (GND), U29.3 (GND), U30.3 (GND), U31.3 (GND), U32.3 (GND), U33.3 (GND), U34.3 (GND), U35.3 (GND), U36.3 (GND), U37.3 (GND), U38.3 (GND), U39.3 (GND), U40.3 (GND), U41.3 (GND), U42.3 (GND), U43.3 (GND), U44.3 (GND), U45.3 (GND), U46.3 (GND), U47.3 (GND), U48.3 (GND), U49.3 (GND), U50.3 (GND), U51.3 (GND), U52.3 (GND), U53.3 (GND), U54.3 (GND), U55.3 (GND), U56.3 (GND), U57.3 (GND), U58.3 (GND), U59.3 (GND), U60.3 (GND); also elsewhere on the board
/next-board00/WS2812: U1.4 (DIN); also elsewhere on the board
/next-board00/WS281200/0-8: U8.2 (DOUT), U9.4 (DIN)
/next-board00/WS281200/1-8: U16.2 (DOUT), U17.4 (DIN)
/next-board00/WS281200/2-8: U24.2 (DOUT), U25.4 (DIN)
/next-board00/WS281200/3-8: U32.2 (DOUT), U33.4 (DIN)
/next-board00/WS281200/4-8: U40.2 (DOUT), U41.4 (DIN)
/next-board00/WS281200/5-8: U48.2 (DOUT), U49.4 (DIN)
/next-board00/WS281200/6-8: U56.2 (DOUT), U57.4 (DIN)
/next-board00/WS281200/DOUT: U60.2 (DOUT); also elsewhere on the board
unnamed: U1.2 (DOUT), U2.4 (DIN)
unnamed: U2.2 (DOUT), U3.4 (DIN)
unnamed: U3.2 (DOUT), U4.4 (DIN)
unnamed: U4.2 (DOUT), U5.4 (DIN)
unnamed: U5.2 (DOUT), U6.4 (DIN)
unnamed: U6.2 (DOUT), U7.4 (DIN)
unnamed: U7.2 (DOUT), U8.4 (DIN)
unnamed: U10.2 (DOUT), U11.4 (DIN)
unnamed: U9.2 (DOUT), U10.4 (DIN)
unnamed: U11.2 (DOUT), U12.4 (DIN)
unnamed: U12.2 (DOUT), U13.4 (DIN)
unnamed: U13.2 (DOUT), U14.4 (DIN)
unnamed: U14.2 (DOUT), U15.4 (DIN)
unnamed: U15.2 (DOUT), U16.4 (DIN)
unnamed: U17.2 (DOUT), U18.4 (DIN)
unnamed: U18.2 (DOUT), U19.4 (DIN)
unnamed: U19.2 (DOUT), U20.4 (DIN)
unnamed: U20.2 (DOUT), U21.4 (DIN)
unnamed: U21.2 (DOUT), U22.4 (DIN)
unnamed: U22.2 (DOUT), U23.4 (DIN)
unnamed: U23.2 (DOUT), U24.4 (DIN)
unnamed: U25.2 (DOUT), U26.4 (DIN)
unnamed: U26.2 (DOUT), U27.4 (DIN)
unnamed: U27.2 (DOUT), U28.4 (DIN)
unnamed: U28.2 (DOUT), U29.4 (DIN)
unnamed: U29.2 (DOUT), U30.4 (DIN)
unnamed: U30.2 (DOUT), U31.4 (DIN)
unnamed: U31.2 (DOUT), U32.4 (DIN)
unnamed: U33.2 (DOUT), U34.4 (DIN)
unnamed: U34.2 (DOUT), U35.4 (DIN)
unnamed: U35.2 (DOUT), U36.4 (DIN)
unnamed: U36.2 (DOUT), U37.4 (DIN)
unnamed: U37.2 (DOUT), U38.4 (DIN)
unnamed: U38.2 (DOUT), U39.4 (DIN)
unnamed: U39.2 (DOUT), U40.4 (DIN)
unnamed: U41.2 (DOUT), U42.4 (DIN)
unnamed: U42.2 (DOUT), U43.4 (DIN)
unnamed: U43.2 (DOUT), U44.4 (DIN)
unnamed: U44.2 (DOUT), U45.4 (DIN)
unnamed: U45.2 (DOUT), U46.4 (DIN)
unnamed: U46.2 (DOUT), U47.4 (DIN)
unnamed: U47.2 (DOUT), U48.4 (DIN)
unnamed: U49.2 (DOUT), U50.4 (DIN)
unnamed: U50.2 (DOUT), U51.4 (DIN)
unnamed: U51.2 (DOUT), U52.4 (DIN)
unnamed: U52.2 (DOUT), U53.4 (DIN)
unnamed: U53.2 (DOUT), U54.4 (DIN)
unnamed: U54.2 (DOUT), U55.4 (DIN)
unnamed: U55.2 (DOUT), U56.4 (DIN)
unnamed: U57.2 (DOUT), U58.4 (DIN)
unnamed: U58.2 (DOUT), U59.4 (DIN)
unnamed: U59.2 (DOUT), U60.4 (DIN)

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
