RoboticsBrno/RB3203-BlackBox/main_board/B.B-V1.2-Lucerna/B.B.kicad_pcb

## KiCad design main_board/B.B-V1.2-Lucerna/B.B.kicad_pcb (continued)

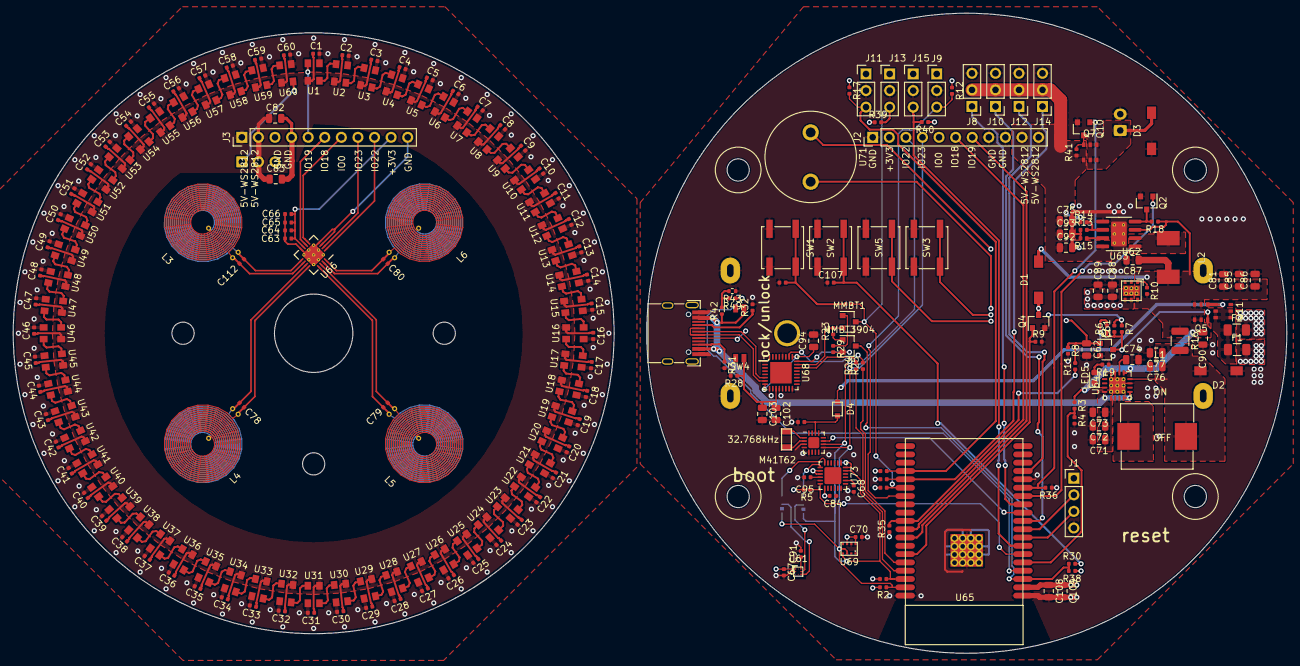
[picture p15: board B.B.kicad_pcb from above]

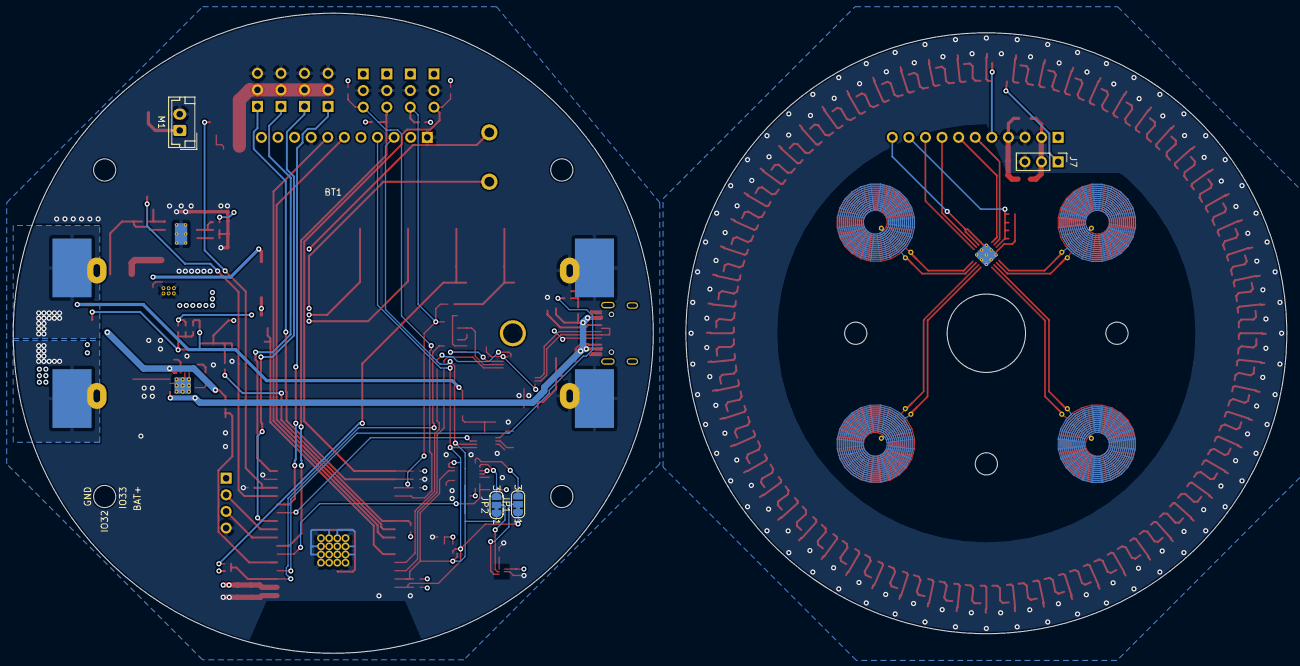
[picture p16: board B.B.kicad_pcb from below]

Board: 4 copper layers, 195.0 x 98.0 mm, 258 parts (5 on the bottom side), 152 nets.

Other parts of the board:
C69, C70: 1uf; R_0402_1005Metric
U67: M41T62; QFN-16-1EP_3x3mm_P0.5mm_EP1.7x1.7mm
U69: SPL06; SMD-8_2x2.5x0.65P

Their connections:
+3V3: C70.1, U69.6, U69.8; also elsewhere on the board
/ESP3200/IO22: U67.10, U69.4; also elsewhere on the board
/ESP3200/IO23: U67.9, U69.3; also elsewhere on the board
/ESP3200/IO26: U67.11; also elsewhere on the board
unnamed 57: C69.1, U67.14; also elsewhere on the board
unnamed 150: U67.1; also elsewhere on the board
unnamed 151: U67.2; also elsewhere on the board
