RoboticsBrno/RB3203-BlackBox/(commit log)

2020-10-27 New_B.B
    New schematic in KiCad.
    -ESP32 wrover
    + ESP32 have programer (CP3202) on board
    + CP3202 is consumed current only if USB is plug in
    -A9G
    + GPS, GPAR
    + SD-Card
    -BMX055 (9-axis sensor, 3xgiroscop, 3x akcelerometr, 3x magnetometr)
    -M41T62 (RTC)
    -SPL06 (barometr)
    -TLV320 (audio systm)
    +TPA2012D2
    + 3.5 jack
    -PCA9555 (I2C pin expandr)
    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
    [B.B.sch, WS2812.sch, board.brd, board.sch, expanz.sch, next-board.sch, perception.sch, power.sch]
2020-11-07 interrupt
    all interapt on PCA9555
    [_saved_B.B.sch, _saved_perception.sch]
2020-11-09 complete_preparation_to_drawing_PCB
    footprint for all component and LCSC code for everything for mounting in JLCPCB
    [A9G+.sch, B.B.sch, ESP32.sch, WS2812.sch, audio.sch, enc.sch, expanz.sch, next-board.sch]
2020-11-09 repare last commit
    i forgot to save some footprint in last commit
    [expanz.sch]
2020-11-12 start vith pcb
    firsxxt proposal component layout of main board
    [A9G+.sch, B.B.kicad_pcb, B.B.sch, ESP32.sch, WS2812.sch, audio.sch, enc.sch, expanz.sch]
2020-11-15 orezavani
    smazaní A9G, SD karty, a zvuku
    [B.B.sch, ESP32.sch, IR.sch, WS2812.sch, _saved_power.sch, enc.sch, expanz.sch, next-board.sch]
2020-11-28 polifuse
    -filtr k prijmaci IR
    -merwni bterky -> za zapinani
    -odstraneni odpojovani nabijecky + oprava napajeciho prouhu
    -odstraneni prevodniku napeti k WS2812
    [ESP32.sch, WS2812.sch, _saved_B.B.sch, charger.sch, expanz.sch, next-board.sch, perception.sch, power.sch]
2020-12-06 napajeni_na_stejne_strane
    -poradi na konektoru
    -napajeni IR prijmece z 5V na VCC
    -vyssi nabijeci proud
    -WS2812_power na IO21
    [B.B.kicad_pcb, B.B.sch, ESP32.sch, WS2812.sch, _saved_B.B.sch, charger.sch, expanz.sch, next-board.sch]
2020-12-11 uvolneni enkoderu
    - dolomitelny enkoder
    - zmenseni via u civek LDC
    - vymena pouzdra USB-C
    - otoceni IR prijmace
    - zakas vylivani medi pod BMX9555
    - odstraneni "ochrannych" odporu k M41T62
    [B.B.kicad_pcb, B.B.sch, ESP32.sch, expanz.sch, perception.sch]
2020-12-15 popisky
    -popisky
    -poladeni uddeleni enkoderu
    -poladeni nayvu drah
    -priopjeni gnd USB
    -poligon V5 na led-desce do spodni vrstvu
    [B.B.kicad_pcb, B.B.sch, ESP32.sch, WS2812.sch, charger.sch, expanz.sch, next-board.sch, perception.sch]
2020-12-16 LDC footprint
    prodlouzeni pedu pro usnadneni rucniho osazovani
    [A9G+.sch, B.B.kicad_pcb, B.B.sch, ESP32.sch, WS2812.sch, audio.sch, charger.sch, expanz.sch]
2020-12-21 JLCdata
    - korekce pozice a natoceni
    - data pro vyrobu
    [B.B.kicad_pcb, B.B.sch, ESP32.sch, WS2812.sch, charger.sch, expanz.sch, hlavniDeska.kicad_pcb, ledDeska.kicad_pcb]
2021-02-02 opravi_a_dodatky MPU/QMC/conn_A9G
    [B.B.kicad_pcb, B.B.sch, ESP32.sch, WS2812.sch, _saved_file601F89DE.sch, _saved_perception.sch, charger.sch, expanz.sch]
2021-05-25 new schema
    [A9G+.sch, B.B.kicad_pcb, B.B.sch, ESP32.sch, HlavniDeska.kicad_pcb, LedDeska.kicad_pcb, SOLID-10.step.SLDPRT, SOLID-12.step.SLDPRT]
2021-05-25 spinana nabijecka a FT232 pcb
    [B.B.kicad_pcb, ESP32.sch, charger.sch]
2021-05-26 vymena rezistoru pro snimani nabijeciho proudu
    [B.B.kicad_pcb, ESP32.sch, HlavniDeska.kicad_pcb, LedDeska.kicad_pcb, charger.sch]
2022-11-12 Outline schematic of the new lantern version
    Division into four PCB (PressPad , LEDBoard, MainBoard and bottom ServoButtonBoard)
    Equipmant:
    PressPad - NFC coil and LDC targets
    LEDBoard - 60 LEDs circle with output conector, LDC and his coil, NFC chip M24SR64
    MainBoard - ESP32 WROVER with CP2102 USB to UART convertor, PowerControler (two chargers TP5100 for charging four bateris 18650, linear regulator for 3V3 branch and stepup for 5V branch, main power switch), A9G (GPS, GPRS, SD card)
    ServoBoard - pin expander CY8C9520A and conectors
    Repo file system - older hardware version is on path hw/old and new rersion have path hw/RB3203. The reasen is possybiliti add folder sw (software) and have w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
    [0Power.kicad_sch, 0WS2812.kicad_sch, A9G+.kicad_sch, A9G+.sch, B.B.kicad_pcb, B.B.sch, BOM.xlsx, BatteriManager.kicad_sch]
2023-07-23 Two 5V brange with automatic shutdown step-up
    [Power.kicad_sch, RB3203.kicad_sch, USB.kicad_sch]
2023-07-23 Simplify of automatic shutdown step-up
    [Power.kicad_sch, RB3203.kicad_sch, USB.kicad_sch]
2023-07-29 5V branch
    [Power.kicad_sch, RB3203.kicad_sch]
